AyeChanAungThwin/Automatic-Water-Level-Controller/images/20191013_220350.jpg

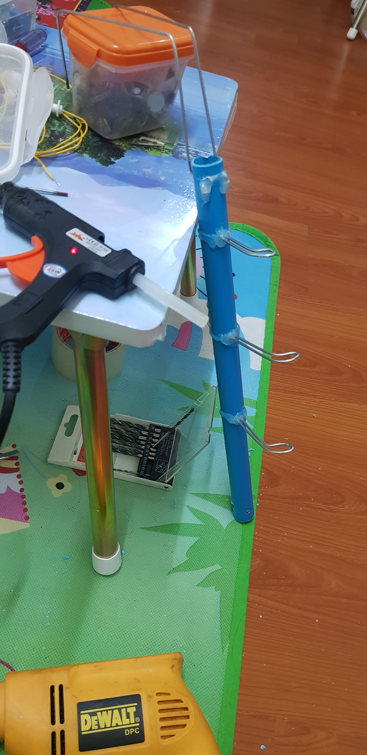
images/20191013_220350.jpg
