AyeChanAungThwin/Automatic-Water-Level-Controller/images/20191013_220834.jpg

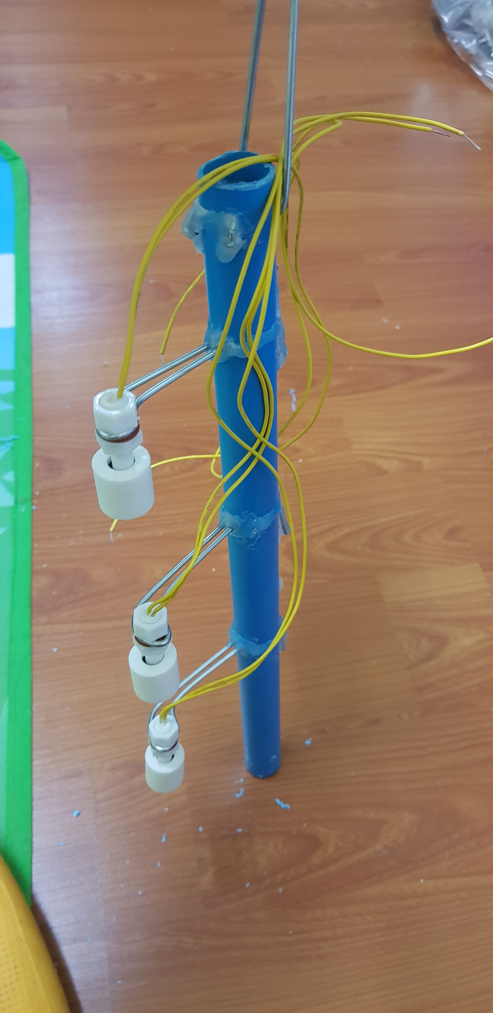
images/20191013_220834.jpg
