AyeChanAungThwin/Automatic-Water-Level-Controller/images/20191021_121100.jpg

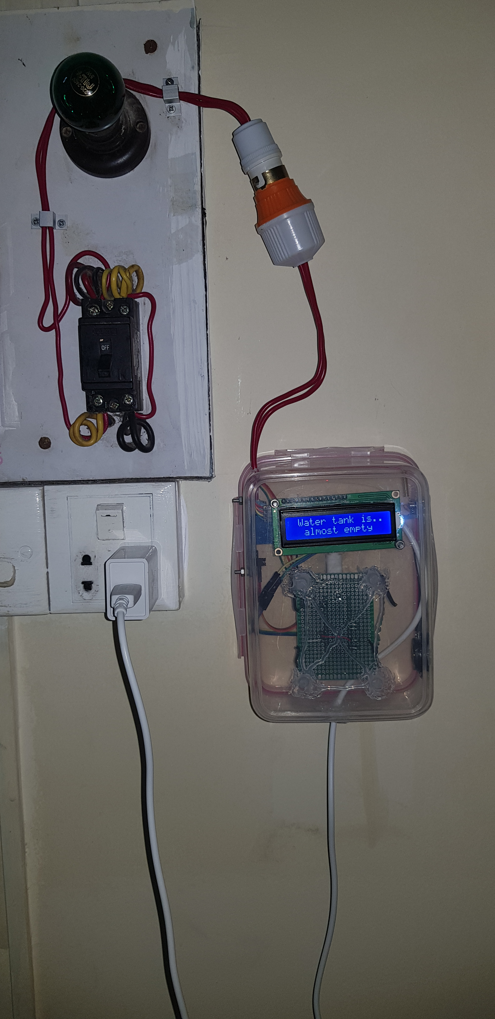
images/20191021_121100.jpg
