AyeChanAungThwin/Automatic-Water-Level-Controller/images/20191021_121133.jpg

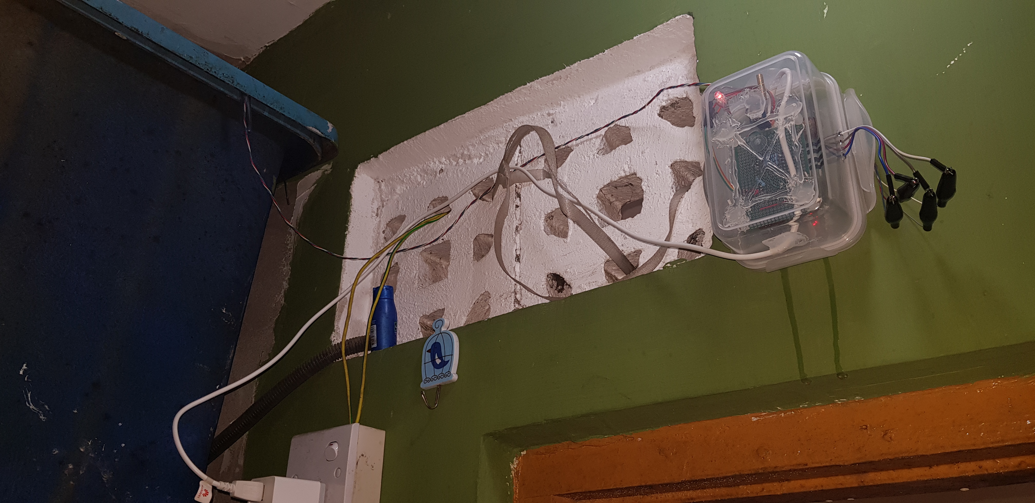
images/20191021_121133.jpg
