AyeChanAungThwin/Automatic-Water-Level-Controller/images/lcd-display-and-i2c-connection.jpg

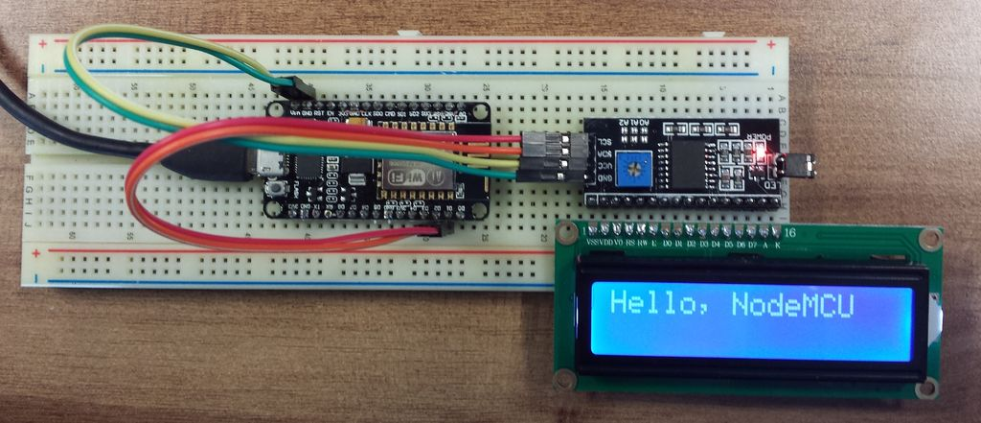
images/lcd-display-and-i2c-connection.jpg
