AyeChanAungThwin/Automatic-Water-Level-Controller/images/relay-module-1-relay-5v.jpg

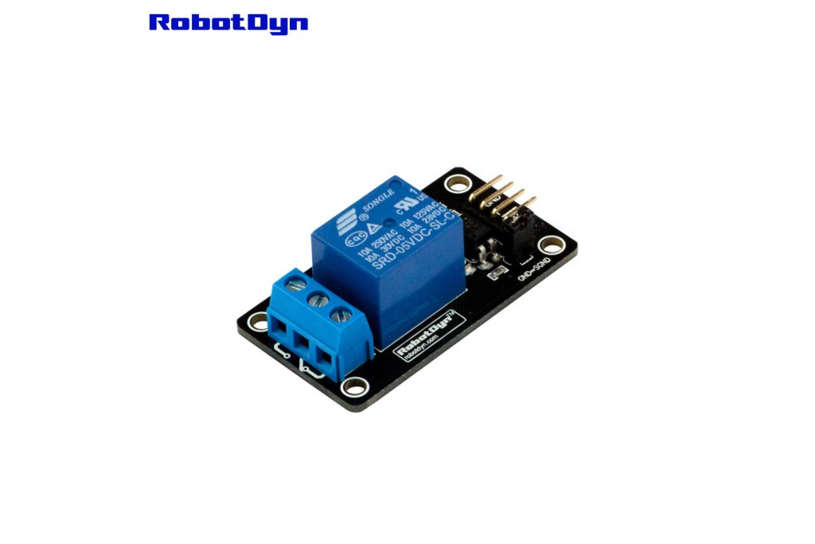
images/relay-module-1-relay-5v.jpg
