AyeChanAungThwin/Automatic-Water-Level-Controller/images/water-level-sensor-float-switch.jpg

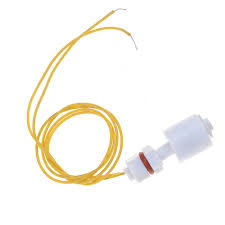
images/water-level-sensor-float-switch.jpg
