AyeChanAungThwin/Automatic-Water-Level-Controller/(commit log)

2019-10-20 updated receiver circuit
2019-10-23 fixed LCD display text
    [Receiver.ino]
